FREILab/DoorLockShield/README.md

FreiLab Door Lock Repo
======================

This reposetory contains all the infos about our RFID door look system.

Have a look in PCB and Code folder to get more infos.
