FREILab/DoorLockShield/Hardware/README.md

Hardware Setup
===============

This folder contains all the infos about the Hardware used for the door setup.

List of Parts
-------------

| Description | Link |
| --- | --- |
| 5V and 24V Power supply | [Power Supply](https://www.netzgeraet.de/schaltnetzteile/schaltnetzteile-duo/7505/duo-netzteil-5v-24v-133w-2fach-ausgang-case-schaltnetzteil.html) |
| | [Door Opener](https://manteca.de/Elektrischer-Tueroeffner-Typ-1420-RF-12-24V-AC/DC-/-Arbeitsstrom-/-Radiusfalle) | 
| | [Drivebelt 1](https://www.zahnriemen24.de/a/40022-zahnriemen-5m-gt-gt3?breite=15&laenge=200&quantity=1)|
| | [Drivebelt 2](https://www.zahnriemen24.de/a/40140-zahnscheiben-5m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) |
| | [Drivebelt 3](https://www.zahnriemen24.de/a/40140-zahnscheiben-5m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) |
| | [Case RFID Card](https://www.conrad.de/de/p/hammond-electronics-rp1025-rp1025c-universal-gehaeuse-65-x-60-x-40-abs-lichtgrau-1-st-539044.html) |
| | [Main Electronics Box](https://www.conrad.de/de/p/spelsberg-tk-pc-3625-11-tm-installations-gehaeuse-254-x-361-x-111-polystyrol-polycarbonat-polyurethan-polyamid-lichtg-1387630.html) |
