FREILab/DoorLockShield/PCB/First_Hand_Schematic.PDF

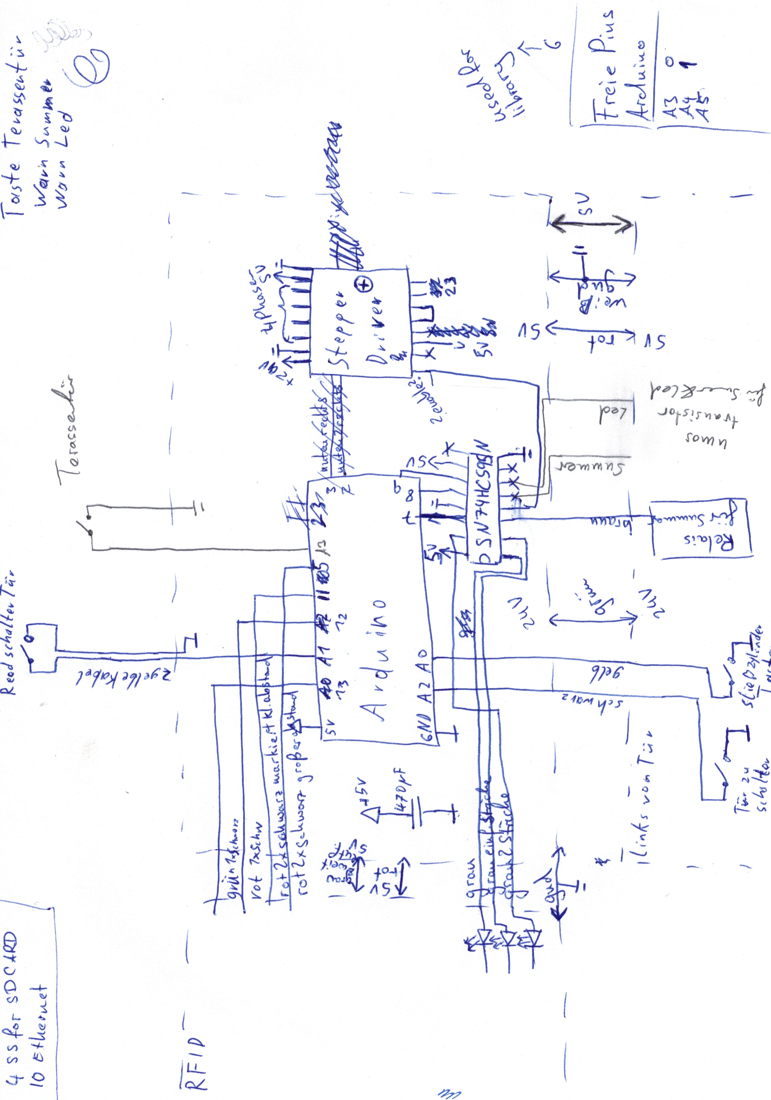
[picture p2: page 1]
