FREILab/DoorLockShield/PCB/DoorLockShield.brd

## EAGLE design PCB/DoorLockShield.brd (2020-02-22)

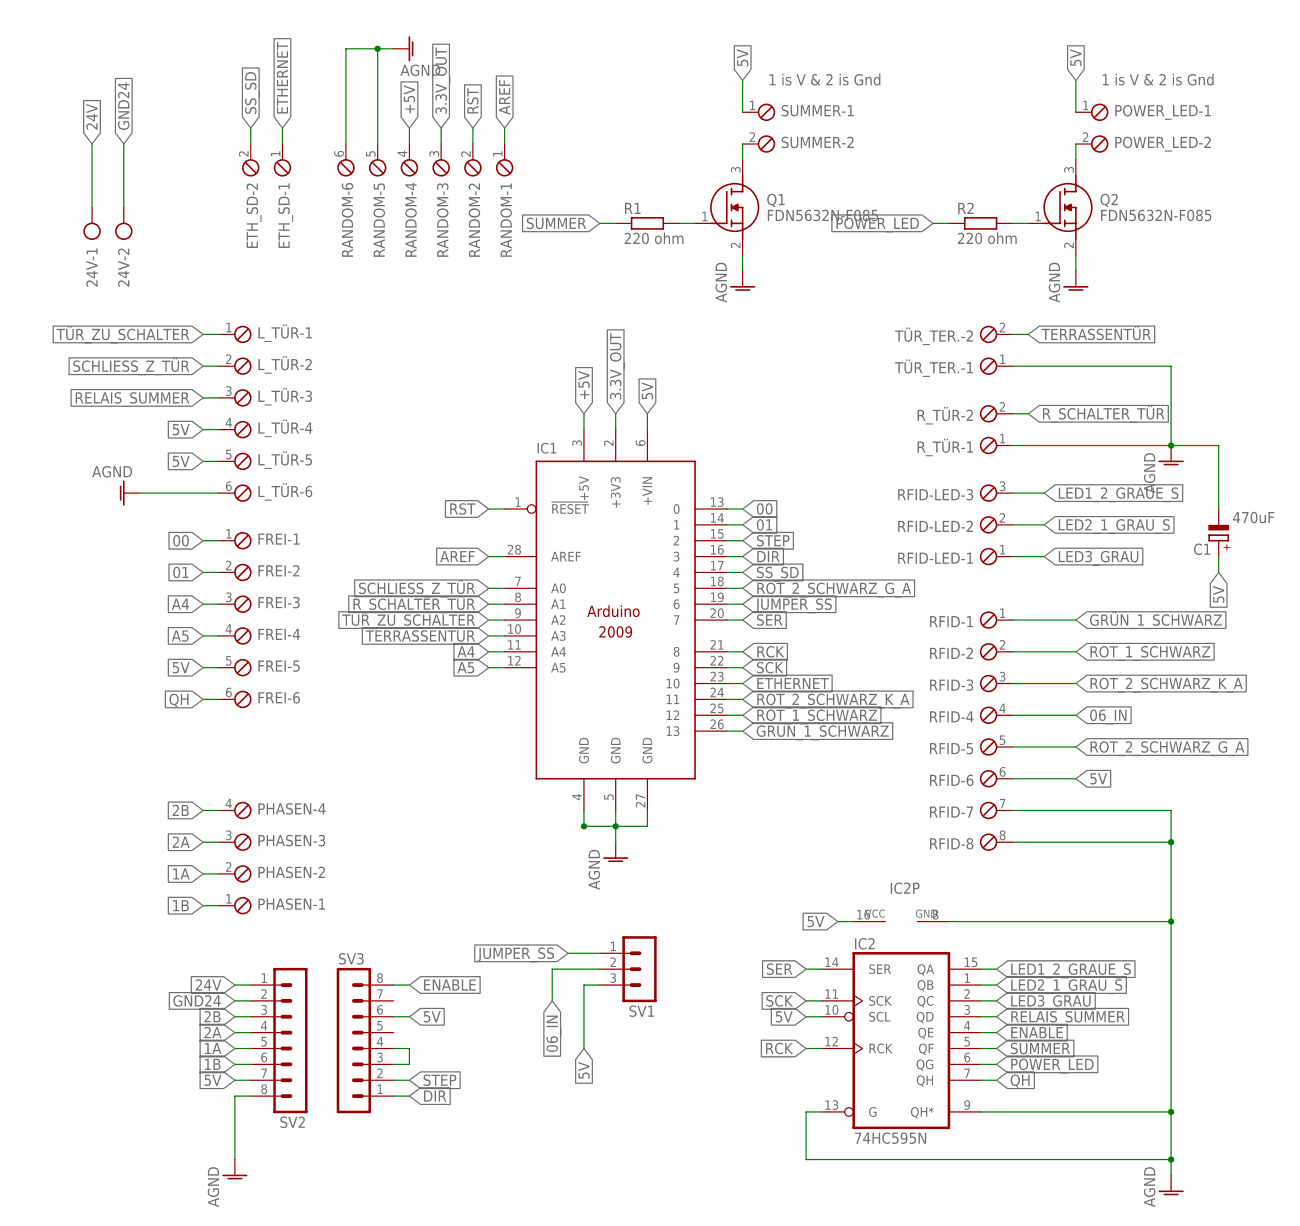
[picture p3: schematic DoorLockShield.sch]

Parts:
24V: AK500/2
C1: 470uF; E7,5-16
ETH_SD: MPT2; 2POL254
FREI: MPT6; 6POL254
IC1: ARDUINO2009_12; ARDUINO2009_2
IC2: 74HC595N; DIL16
L_TÜR: MPT6; 6POL254
PHASEN: MPT4; 4POL254
POWER_LED: 1 is V & 2 is Gnd; 2POL254
Q1, Q2: FDN5632N-F085; SOT95P237X122-3N
R1, R2: 220 ohm; R0805
RANDOM: MPT6; 6POL254
RFID: MPT8; 8POL254
RFID-LED: MPT3; 3POL254
R_TÜR: MPT2; 2POL254
SUMMER: 1 is V & 2 is Gnd; 2POL254
SV1: MA03-1
SV2, SV3: MA08-1
TÜR_TER.: MPT2; 2POL254

Connections:
00: FREI.1, IC1.13 (0)
01: FREI.2, IC1.14 (1)
1A: PHASEN.2, SV2.5
1B: PHASEN.1, SV2.6
2A: PHASEN.3, SV2.4
2B: PHASEN.4, SV2.3
3.3V_OUT: IC1.2 (+3V3), RANDOM.3
5V: C1.+, FREI.5, IC1.6 (+VIN), IC2.10 (SCL), IC2.16 (VCC), L_TÜR.4, L_TÜR.5, POWER_LED.1, RFID.6, SUMMER.1, SV1.3, SV2.7, SV3.6
06_IN: RFID.4, SV1.2
24V: 24V.1, SV2.1
+5V: IC1.3 (+5V), RANDOM.4
A4: FREI.3, IC1.11 (A4)
A5: FREI.4, IC1.12 (A5)
AGND: C1.-, IC1.4 (GND), IC1.5 (GND), IC1.27 (GND), IC2.8 (GND), IC2.9 (QH*), IC2.13 (G), L_TÜR.6, Q1.2 (S), Q2.2 (S), RANDOM.5, RANDOM.6, RFID.7, RFID.8, R_TÜR.1, SV2.8, TÜR_TER..1
AREF: IC1.28 (AREF), RANDOM.1
DIR: IC1.16 (3), SV3.1
ENABLE: IC2.4 (QE), SV3.8
ETHERNET: ETH_SD.1, IC1.23 (10)
GND24: 24V.2, SV2.2
GRÜN_1_SCHWARZ: IC1.26 (13), RFID.1
JUMPER_SS: IC1.19 (6), SV1.1
LED1_2_GRAUE_S: IC2.15 (QA), RFID-LED.3
LED2_1_GRAU_S: IC2.1 (QB), RFID-LED.2
LED3_GRAU: IC2.2 (QC), RFID-LED.1
unnamed: Q1.1 (G), R1.2
unnamed: Q2.1 (G), R2.2
unnamed: POWER_LED.2, Q2.3 (D)
unnamed: Q1.3 (D), SUMMER.2
unnamed: SV3.3, SV3.4
POWER_LED: IC2.6 (QG), R2.1
QH: FREI.6, IC2.7 (QH)
RCK: IC1.21 (8), IC2.12 (RCK)
RELAIS_SUMMER: IC2.3 (QD), L_TÜR.3
ROT_1_SCHWARZ: IC1.25 (12), RFID.2
ROT_2_SCHWARZ_G_A: IC1.18 (5), RFID.5
ROT_2_SCHWARZ_K_A: IC1.24 (11), RFID.3
RST: IC1.1 (!RESET), RANDOM.2
R_SCHALTER_TÜR: IC1.8 (A1), R_TÜR.2
SCHLIESS_Z_TÜR: IC1.7 (A0), L_TÜR.2
SCK: IC1.22 (9), IC2.11 (SCK)
SER: IC1.20 (7), IC2.14 (SER)
SS_SD: ETH_SD.2, IC1.17 (4)
STEP: IC1.15 (2), SV3.2
SUMMER: IC2.5 (QF), R1.1
TERRASSENTÜR: IC1.10 (A3), TÜR_TER..2
TÜR_ZU_SCHALTER: IC1.9 (A2), L_TÜR.1

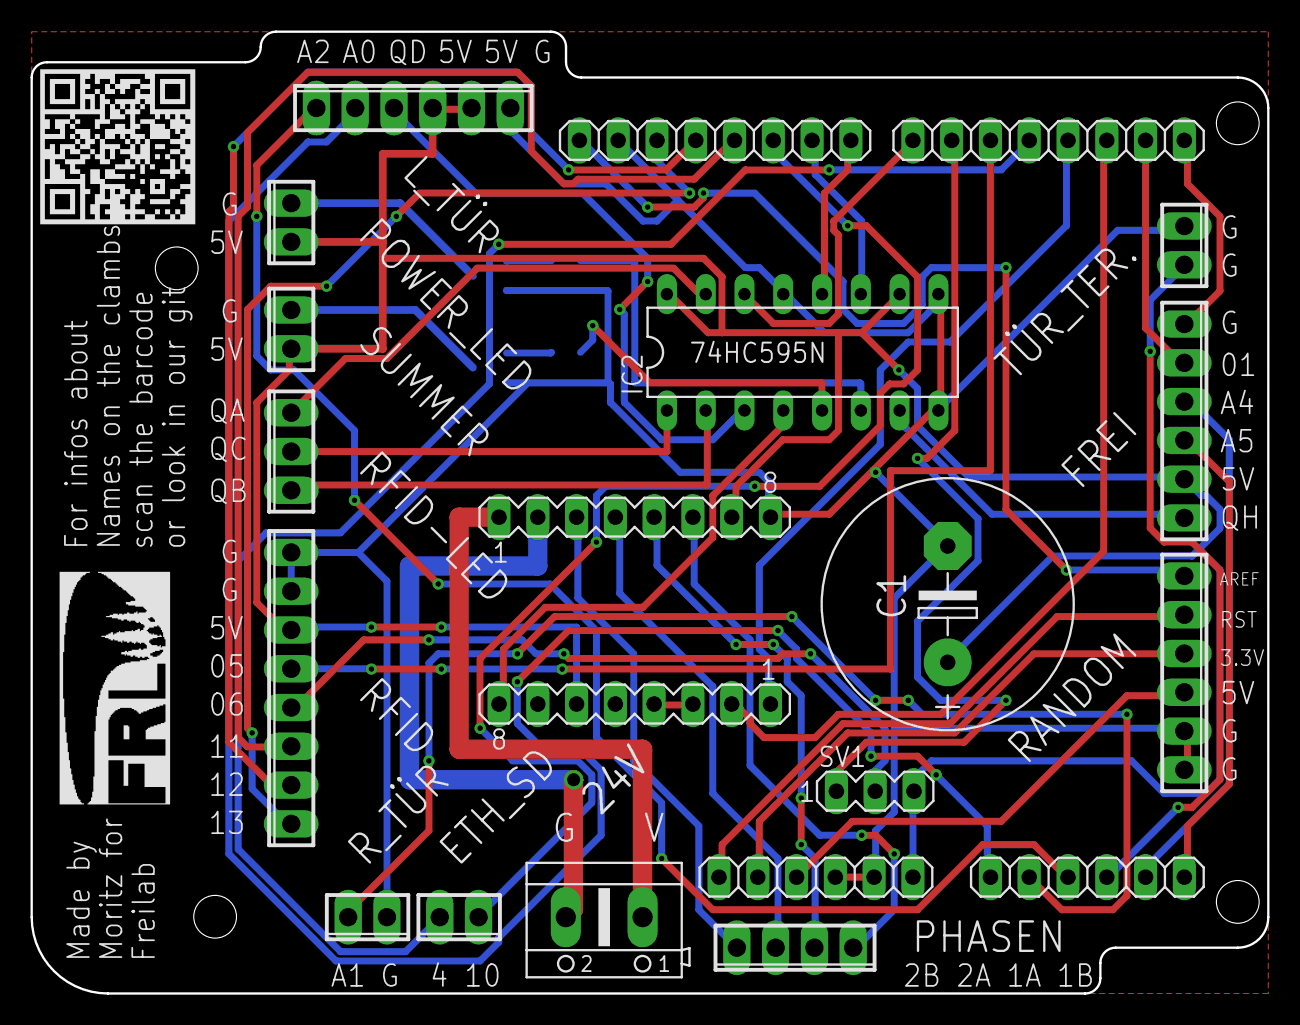
[picture p4: board DoorLockShield.brd from above]

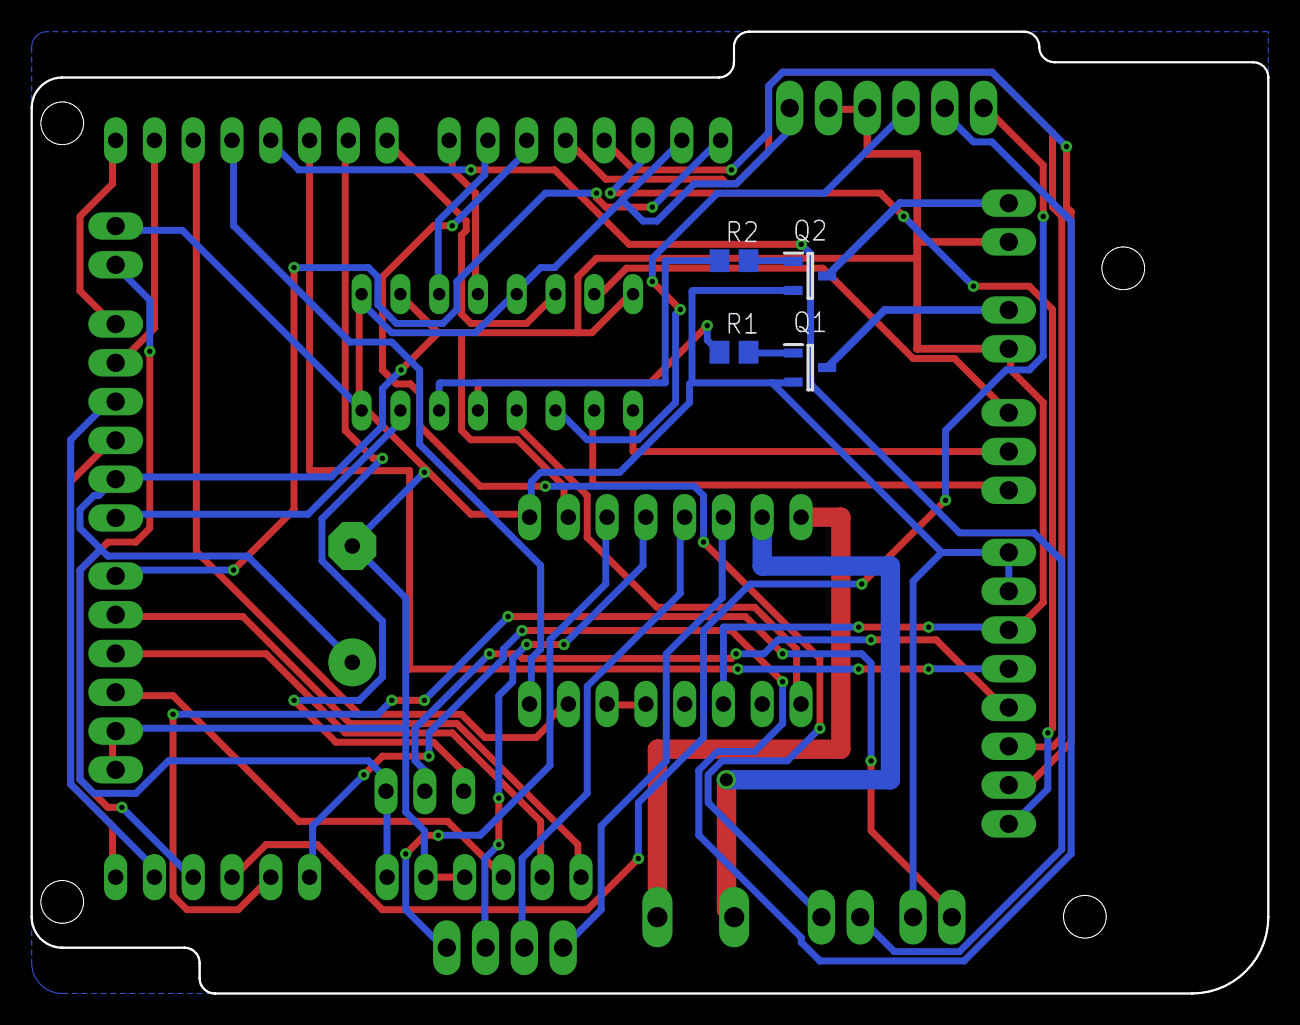
[picture p5: board DoorLockShield.brd from below]

Board: 2 copper layers, 81.0 x 63.0 mm, 22 parts (4 on the bottom side), 46 nets.
