FREILab/DoorLockShield/(commit log)

2019-11-20 added Mess schematic
    [DoorLockShield.brd, DoorLockShield.sch]
2019-11-21 added schematic
    [DoorLockShield.brd, DoorLockShield.sch]
2019-11-24 finalized schematik
    [DoorLockShield.brd, DoorLockShield.sch]
2019-11-26 started to add brd
    [DoorLockShield.brd, DoorLockShield.sch]
2019-11-27 added description names on sch and brd
    [DoorLockShield.brd, DoorLockShield.sch]
2019-11-27 small design change in brd
    [DoorLockShield.brd]
2019-12-01 final boeard has to be reviewed
    [DoorLockShield.brd]
2019-12-05 added Readme info
    [DoorLockShield.brd, DoorLockShield.sch]
2020-02-22 changed naming in board layout to match net names
    [DoorLockShield.brd]
2023-05-07 restructure content and added code for door shield
    [DoorLockShield.brd, DoorLockShield.sch]
2023-06-08 door is simply working, have to find correct steps for nema 17
    [main.cpp]
